xephyre57/projet-1A-controleur-moteur/docs/mb1419_bom/MB1419-G431CBU6-B01_BOM.xlsx

 |  |  | Bill of materials
 |  |  | Board reference: | MB1419
 |  |  | Variant: | G431CBU6
 |  |  | PCB revision: | B
 |  |  | Assembly revision: | 01
 |  |  | Date: | 20/03/2019
Designator | Description | Package | Manufacturer | Manufacturer_Part_Number | Fitted | Quantity
C1 C2 C3 C4 C5 C9 C13 C17 C18 C20 C21 C22 C23 C24 C70 | CAP CER 0.1UF 16V X7R 0402 | 0402 (1005 Metric) | Wurth Electronics Inc. | 885012205037 |  | 15
C6 | CAP CER 10UF 16V X5R 0805 | 0805 (2012 Metric) | Wurth Electronics Inc. | 885012107014 |  | 1
C7 | CAP CER 4.7UF 16V X5R 0805 | 0805 (2012 Metric) | Wurth Electronics Inc. | 885012107013 |  | 1
C8 | CAP CER 100PF 10V C0G/NP0 0402 | 0402 (1005 Metric) | Wurth Electronics Inc. | 885012005013 |  | 1
C10 C11 C67 C68 C69 | CAP CER 10PF 10V C0G/NP0 0402 | 0402 (1005 Metric) | Wurth Electronics Inc. | 885012005007 |  | 5
C12 | CAP CER 0402-NOT MOUNTED | 0402 (1005 Metric) |  |  | Not Fitted | 1
C14 C16 | CAP CER 1UF 16V X5R 0603 | 0603 (1608 Metric) | Yageo | CC0603KRX5R7BB105 |  | 2
C15 | CAP CER 0.1UF 16V X7R 0603 | 0603 (1608 Metric) | Wurth Electronics Inc. | 885012206046 |  | 1
C19 | CAP CER 4.7UF 10V X5R 0603 | 0603 (1608 Metric) | Wurth Electronics Inc. | 885012106012 |  | 1
C25 C56 C63 | CAP CER 1UF 25V X5R 0402 | 0402 (1005 Metric) | Murata Electronics North America | GRM155R61E105KA12D |  | 3
C26 | CAP CER 10000PF 16V X7R 0402 | 0402 (1005 Metric) | Wurth Electronics Inc. | 885012205031 |  | 1
C27 C28 C29 C30 C31 C32 C33 C34 C35 C36 C37 C38 C39 C40 | CAP CER 15UF 35V X5R 0805 | 0805 (2012 Metric) | TDK Corporation | C2012X5R1V156M125AC |  | 14
C41 | CAP CER 0.22UF 50V X7R 0603 | 0603 (1608 Metric) | TDK Corporation | CGA3E3X7R1H224K080AD |  | 1
C42 | CAP CER 3900PF 16V X7R 0402 | 0402 (1005 Metric) | KEMET | C0402C392K4RAC7867 |  | 1
C43 C52 C58 | CAP CER 1UF 25V X7R 0603 | 0603 (1608 Metric) | Wurth Electronics Inc. | 885012206076 |  | 3
C44 | CAP CER 10UF 50V X7R 1206 | 1206 (3216 Metric) | Samsung Electro-Mechanics America, Inc. | CL31B106KBHNNNE |  | 1
C45 | CAP CER 22UF 25V X5R 1206 | 1206 (3216 Metric) | Murata Electronics North America | GRT31CR61E226ME01L |  | 1
C46 | CAP CER 27PF 25V C0G/NP0 0402 | 0402 (1005 Metric) | Murata Electronics North America | GRM1555C1E270JA01D |  | 1
C47 C48 C53 C54 C60 C61 | CAP CER 100PF 25V X7R 0402 | 0402 (1005 Metric) | Wurth Electronics Inc. | 885012205038 |  | 6
C49 C55 C62 | CAP CER 0.47UF 25V X7R 0603 | 0603 (1608 Metric) | Wurth Electronics Inc. | 885012206075 |  | 3
C50 | CAP CER 4700PF 16V X7R 0402 | 0402 (1005 Metric) | Wurth Electronics Inc. | 885012205029 |  | 1
C51 C59 C65 | CAP CER 10000PF 100V X7R 0603 | 0603 (1608 Metric) | TDK Corporation | C1608X7R2A103M080AA |  | 3
C57 C64 | CAP CER 2.2UF 10V X5R 0402 | 0402 (1005 Metric) | Wurth Electronics Inc. | 885012105013 |  | 2
C66 | CAP CER 10000PF 10V X7R 0402 | 0402 (1005 Metric) | Wurth Electronics Inc. | 885012205012 |  | 1
D1 | DIODE SCHOTTKY 20V 1A STMITEFLAT | DO-222AA | STMicroelectronics | STPS1L20MF |  | 1
D2 | LED GREEN/RED CLEAR 4PLCC SMD | 4-PLCC | Wurth Electronics Inc. | 150141RV73100 |  | 1
D3 D5 | LED GREEN 0402 SMD | 0402 (1005 Metric) | Panasonic Electronic Components | LNJ347W83RA |  | 2
D4 | DIO, Rectangle with Flat Top, 1.00mm x 0.50mm, VLMS1500-GS08, 20mA, --, --, 0402 (1005 Metric) | 0402 (1005 Metric) | Vishay Semiconductor Opto Division | VLMS1500-GS08 |  | 1
D6 D8 D9 | DIODE SCHOTTKY 60V 500MA SOD123 | SOD-123 | STMicroelectronics | STPS0560Z |  | 3
D7 | DIODE SCHOTTKY 40V 1A STMITE | DO-216AA | STMicroelectronics | STPS1L40M |  | 1
D10 D11 D12 D13 D14 D15 D16 D17 D18 D19 | DIODE SCHOTTKY 30V 300MA SOD523 | SC-79, SOD-523 | STMicroelectronics | BAT30KFILM |  | 10
D20 | 400 W TVS in STmite Flat | DO216-AA-FLAT | STMicroelectronics | SMM4F26A-TR |  | 1
F1 | FUSE BOARD MNT 250MA 32VDC 0402 | 0.039" L x 0.020" W x 0.013" H (0.99mm x 0.51mm x 0.33mm) | Littelfuse Inc. | 0435.250KRS |  | 1
J1 | SOLDER PADS |  |  |  | Not Fitted | 1
J2 | SOLDER PADS |  |  |  | Not Fitted | 1
J3 | SOLDER PADS |  |  |  | Not Fitted | 1
J4 | SOLDER PADS |  |  |  | Not Fitted | 1
J5 | SOLDER PADS |  |  |  | Not Fitted | 1
J6 | SOLDER PADS |  |  |  | Not Fitted | 1
J7 | SOLDER PADS |  |  |  | Not Fitted | 1
J8 | SOLDER PADS |  |  |  | Not Fitted | 1
JP1 JP2 JP3 | 2 PIN SHORTED TO CONNECT DIFFERENT NETS |  |  |  | Not Fitted | 3
L1 | FERRITE BEAD 600 OHM 0402 1LN | 0402 (1005 Metric) | Murata Electronics North America | BLM15BX601SN1D |  | 1
L2 | Fixed Inductors LPS4018 Low Profile 33uH 0.8A 20% SMD | 3.9x3.9x1.7 | Coilcraft | LPS4018-333MRB |  | 1
Q1 | TRANS NPN 60V 1A SOT-23 | TO-236-3, SC-59, SOT-23-3 | STMicroelectronics | 2STR1160 |  | 1
Q2 Q3 Q4 Q5 Q6 Q7 | N-channel 60 V, 1.9 mO typ., 120 A STripFET™ F7 | PowerFLAT 5x6 | STMicroelectronics | STL180N6F7 |  | 6
R1 | RES SMD 120 OHM 1% 1/16W 0402 | 0402 (1005 Metric) | Yageo | RC0402FR-07120RL |  | 1
R2 | TRIMMER 10K OHM 0.5W PC PIN | Square - 0.375" x 0.375" Face x 0.190" H (9.53mm x 9.53mm x 4.83mm) | Bourns Inc. | 3386P-1-103TLF |  | 1
R3 R10 R12 R16 R35 R39 R41 R45 R46 R48 R52 R53 R71 R72 R73 | RES SMD 10K OHM 1% 1/16W 0402 | 0402 (1005 Metric) | Yageo | RC0402FR-0710KL |  | 15
R4 R8 R9 R18 R20 | RES SMD 100 OHM 1% 1/16W 0402 | 0402 (1005 Metric) | TE Connectivity Passive Product | CRG0402F100R |  | 5
R5 R67 R69 R70 | RES SMD 1.5K OHM 1% 1/16W 0402 | 0402 (1005 Metric) | Yageo | RC0402FR-071K5L |  | 4
R6 | RES SMD 36K OHM 1% 1/16W 0402 | 0402 (1005 Metric) | Yageo | RC0402FR-0736KL |  | 1
R7 R13 R15 | RES SMD 100K OHM 1% 1/16W 0402 | 0402 (1005 Metric) | TE Connectivity Passive Product | CRG0402F100K |  | 3
R11 R26 | RES SMD 0 OHM JUMPER 1/16W 0402 | 0402 (1005 Metric) | Vishay Dale | CRCW04020000Z0ED |  | 2
R14 | RES SMD 2.7K OHM 1% 1/16W 0402 | 0402 (1005 Metric) | Yageo | RC0402FR-072K7L |  | 1
R17 | RES SMD 0402 - NOT MOUNTED | 0402 (1005 Metric) |  |  | Not Fitted | 1
R19 R22 R30 R60 | RES SMD 4.7K OHM 1% 1/16W 0402 | 0402 (1005 Metric) | TE Connectivity Passive Product | CRG0402F4K7 |  | 4
R21 | RES SMD 1K OHM 1% 1/16W 0402 | 0402 (1005 Metric) | Yageo | RC0402FR-071KL |  | 1
R23 R24 | RES SMD 0 OHM JUMPER 1/10W 0603 | 0603 (1608 Metric) | Panasonic Electronic Components | ERJ-3GEY0R00V |  | 2
R27 | RES SMD 220 OHM 1% 1/16W 0402 | 0402 (1005 Metric) | Yageo | RC0402FR-07220RL |  | 1
R28 R29 | RES SMD 510 OHM 1% 1/16W 0402 | 0402 (1005 Metric) | Yageo | RC0402FR-07510RL |  | 2
R31 | RES SMD 62 OHM 1% 1/16W 0402 | 0402 (1005 Metric) | Yageo | RC0402FR-0762RL |  | 1
R32 | RES SMD 34.8K OHM 1% 1/16W 0402 | 0402 (1005 Metric) | Yageo | RC0402FR-0734K8L |  | 1
R33 | RES SMD 300 OHM 1% 1/16W 0402 | 0402 (1005 Metric) | Yageo | RC0402FR-07300RL |  | 1
R34 R38 R40 R43 R47 R50 | RES SMD 33 OHM 1% 1/10W 0603 | 0603 (1608 Metric) | Yageo | 9C06031A33R0FKHFT |  | 6
R36 | RES SMD 8.2K OHM 5% 1/16W 0402 | 0402 (1005 Metric) | Yageo | RC0402JR-078K2L |  | 1
R37 R44 R51 | RES SMD 1 OHM 5% 1/8W 0805 | 0805 (2012 Metric) | Panasonic Electronic Components | ERJ-6GEYJ1R0V |  | 3
R42 | RES SMD 52.3K OHM 1% 1/16W 0402 | 0402 (1005 Metric) | Samsung Electro-Mechanics | RC1005F5232CS |  | 1
R49 | RES SMD 30.9K OHM 1% 1/10W 0402 | 0402 (1005 Metric) | Panasonic Electronic Components | ERJ-2RKF3092X |  | 1
R54 R55 R56 | RES 0.003 OHM 1% 3W 2512 | 2512 (6432 Metric) | TE Connectivity Passive Product | TLR3A30DR003FTDG |  | 3
R57 R58 R59 | RES SMD 2.2K OHM 1% 1/16W 0402 | 0402 (1005 Metric) | Yageo | RC0402FR-072K2L |  | 3
R61 R62 R63 | RES SMD 10K OHM 1% 1/10W 0603 | 0603 (1608 Metric) | Yageo | RC0603FR-0710KL |  | 3
R68 | RES SMD 169K OHM 1% 1/16W 0402 | 0402 (1005 Metric) | Yageo | RC0402FR-07169KL |  | 1
R74 R75 R77 | RES SMD 1.8K OHM 1% 1/16W 0402 | 0402 (1005 Metric) | Yageo | RC0402FR-071K8L |  | 3
R76 | RES SMD 18K OHM 1% 1/16W 0402 | 0402 (1005 Metric) | Yageo | RC0402FR-0718KL |  | 1
RT1 | NTC THERMISTOR 10K OHM 1% 0402 | 0402 (1005 Metric) | TDK Corporation | NTCG103JF103FT1 |  | 1
R64 R65 R66 | RES SMD 22K OHM 1% 1/16W 0402 | 0402 (1005 Metric) | Panasonic Electronic Components | ERJ-2RKF2202X |  | 3
R80 R81 R82 | RES SMD 2.2K OHM 1% 1/16W 0402 | 0402 (1005 Metric) | Yageo | RC0402FR-072K2L |  | 3
SW1 | SWITCH TACTILE SPST-NO 0.05A 32V | 4.60mm x 2.80mm | C&K | KMR211GLFS |  | 1
TP1 TP2 TP3 | TEST POINT 1MM SMD PADSTASCK |  |  |  | Not Fitted | 3
U1 | IC ANLG SWITCH SGL SPDT 6QFN | 6-UFDFN | STMicroelectronics | AS11P2TLRQ |  | 1
U2 | IC TXRX CAN 3.3V SOT-23 | SOT-23-8 | Texas Instruments | TCAN330DCNT |  | 1
U3 | IC REG LINEAR 5V 800MA SOT223 | TO-261-4, TO-261AA | STMicroelectronics | LD1117S50TR |  | 1
U4 | CONN RCPT 5POS MICRO USB R/A |  | Molex, LLC | 0473460001 |  | 1
U5 | IC PWR SWITCH 1.2A HISIDE 8-DFN | 8-VDFN Exposed Pad | STMicroelectronics | ST890DTR |  | 1
U6 | IC MCU 32BIT 128KB FLASH 48LQFP | 48-LQFP | STMicroelectronics | STM32F103CBT6 |  | 1
U7 | IC REG LINEAR 3.3V 500MA 6DFN | 6-VDFN Exposed Pad | STMicroelectronics | LD39050PU33R |  | 1
U8 | IC MCU 32BIT | 48-UFQFPN | STMicroelectronics | STM32G431CBU6 |  | 1
U9 | IC REG BUCK ADJ 3A 10VDFPN | 10-VFDFN Exposed Pad | STMicroelectronics | L7986TR |  | 1
U10 U11 U13 | IC DRIVER HI/LO SIDE HV 8-SOIC | 8-SOIC (0.154", 3.90mm Width) | STMicroelectronics | L6387ED |  | 3
U12 U14 | IC REG LINEAR POS ADJ 1A 6DFN | 6-VDFN Exposed Pad | STMicroelectronics | LDFPVR |  | 2
Y1 | CRYSTAL 8.0000MHZ 8PF SMD | 0.126" L x 0.098" W (3.20mm x 2.50mm) | NDK America, Inc. | NX3225GD-8MHZ-STD-CRA-3 |  | 1
Y2 | CER RES 8.0000MHZ 33PF SMD | 0.126" L x 0.051" W (3.20mm x 1.30mm) | Murata Electronics North America | CSTCE8M00G15C99-R0 |  | 1
