xephyre57/projet-1A-controleur-moteur/(list of files, drawings)

Other design files:
docs/mb1419_bdp/MB1419_B01/CAN.SchDoc
docs/mb1419_bdp/MB1419_B01/DAUGHTERBOARD.SchDoc
docs/mb1419_bdp/MB1419_B01/MB1419.PrjPcb
docs/mb1419_bdp/MB1419_B01/MCU.SchDoc
docs/mb1419_bdp/MB1419_B01/POWER STAGE.SchDoc
docs/mb1419_bdp/MB1419_B01/Project_Overview.SchDoc
docs/mb1419_bdp/MB1419_B01/SENSING.SchDoc
docs/mb1419_bdp/MB1419_B04/CAN.SchDoc
docs/mb1419_bdp/MB1419_B04/DAUGHTERBOARD.SchDoc
docs/mb1419_bdp/MB1419_B04/MB1419.PrjPcb
docs/mb1419_bdp/MB1419_B04/MCU.SchDoc
docs/mb1419_bdp/MB1419_B04/POWER STAGE.SchDoc
docs/mb1419_bdp/MB1419_B04/Project_Overview.SchDoc
docs/mb1419_bdp/MB1419_B04/SENSING.SchDoc
docs/mb1419_bdp/MB1419_C01/CAN.SchDoc
docs/mb1419_bdp/MB1419_C01/DAUGHTERBOARD.SchDoc
docs/mb1419_bdp/MB1419_C01/MB1419.PrjPcb
docs/mb1419_bdp/MB1419_C01/MCU.SchDoc
docs/mb1419_bdp/MB1419_C01/POWER STAGE.SchDoc
docs/mb1419_bdp/MB1419_C01/Project_Overview.SchDoc
docs/mb1419_bdp/MB1419_C01/SENSING.SchDoc
