xephyre57/projet-1A-controleur-moteur/Control-Board/Kicad/BLDC-Control-Board.kicad_pcb

## KiCad design Control-Board/Kicad/BLDC-Control-Board.kicad_pcb (2026-05-30)

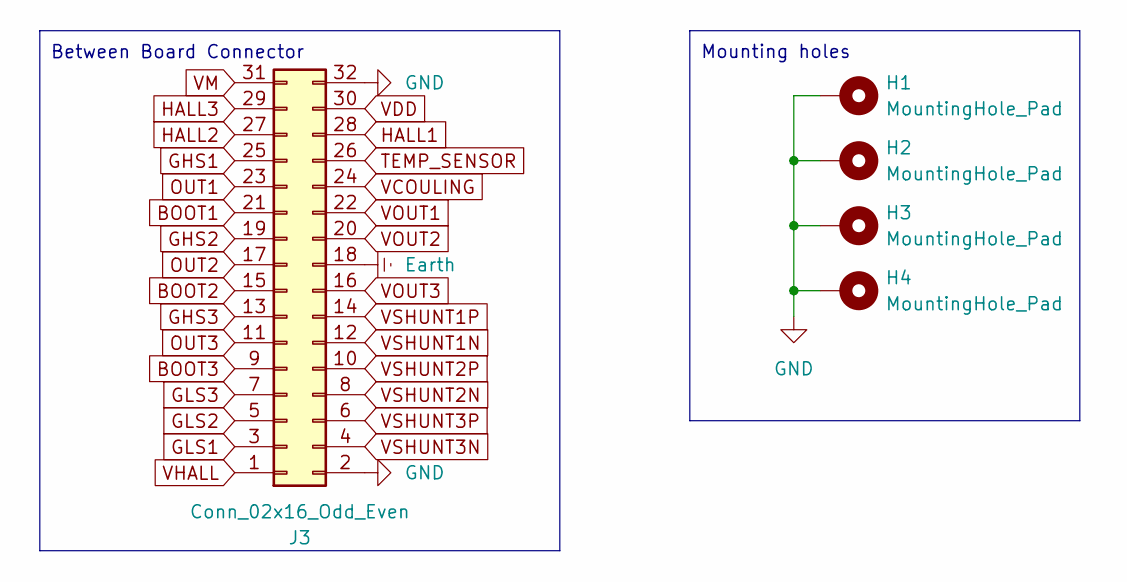
[picture p23: schematic connector.kicad_sch, BLDC Control Board]

Parts:
H1, H2, H3, H4: MountingHole_Pad; MountingHole_3.2mm_M3_DIN965_Pad
J3: Conn_02x16_Odd_Even; PinHeader_2x16_P2.54mm_Vertical

Connections:
BOOT1: J3.21; also elsewhere on the board
BOOT2: J3.15; also elsewhere on the board
BOOT3: J3.9; also elsewhere on the board
Earth: H1.1, H2.1, H3.1, H4.1, J3.2, J3.18, J3.32; also elsewhere on the board
GHS1: J3.25; also elsewhere on the board
GHS2: J3.19; also elsewhere on the board
GHS3: J3.13; also elsewhere on the board
GLS1: J3.3; also elsewhere on the board
GLS2: J3.5; also elsewhere on the board
GLS3: J3.7; also elsewhere on the board
HALL1: J3.28; also elsewhere on the board
HALL2: J3.27; also elsewhere on the board
HALL3: J3.29; also elsewhere on the board
OUT1: J3.23; also elsewhere on the board
OUT2: J3.17; also elsewhere on the board
OUT3: J3.11; also elsewhere on the board
TEMP_SENSOR: J3.26; also elsewhere on the board
VBAT: J3.30; also elsewhere on the board
VCOULING: J3.24; also elsewhere on the board
VHALL: J3.1; also elsewhere on the board
VM: J3.31; also elsewhere on the board
VOUT1: J3.22; also elsewhere on the board
VOUT2: J3.20; also elsewhere on the board
VOUT3: J3.16; also elsewhere on the board
VSHUNT1N: J3.12; also elsewhere on the board
VSHUNT1P: J3.14; also elsewhere on the board
VSHUNT2N: J3.8; also elsewhere on the board
VSHUNT2P: J3.10; also elsewhere on the board
VSHUNT3N: J3.4; also elsewhere on the board
VSHUNT3P: J3.6; also elsewhere on the board

Notes on the sheet:
Mounting holes
Between Board Connector

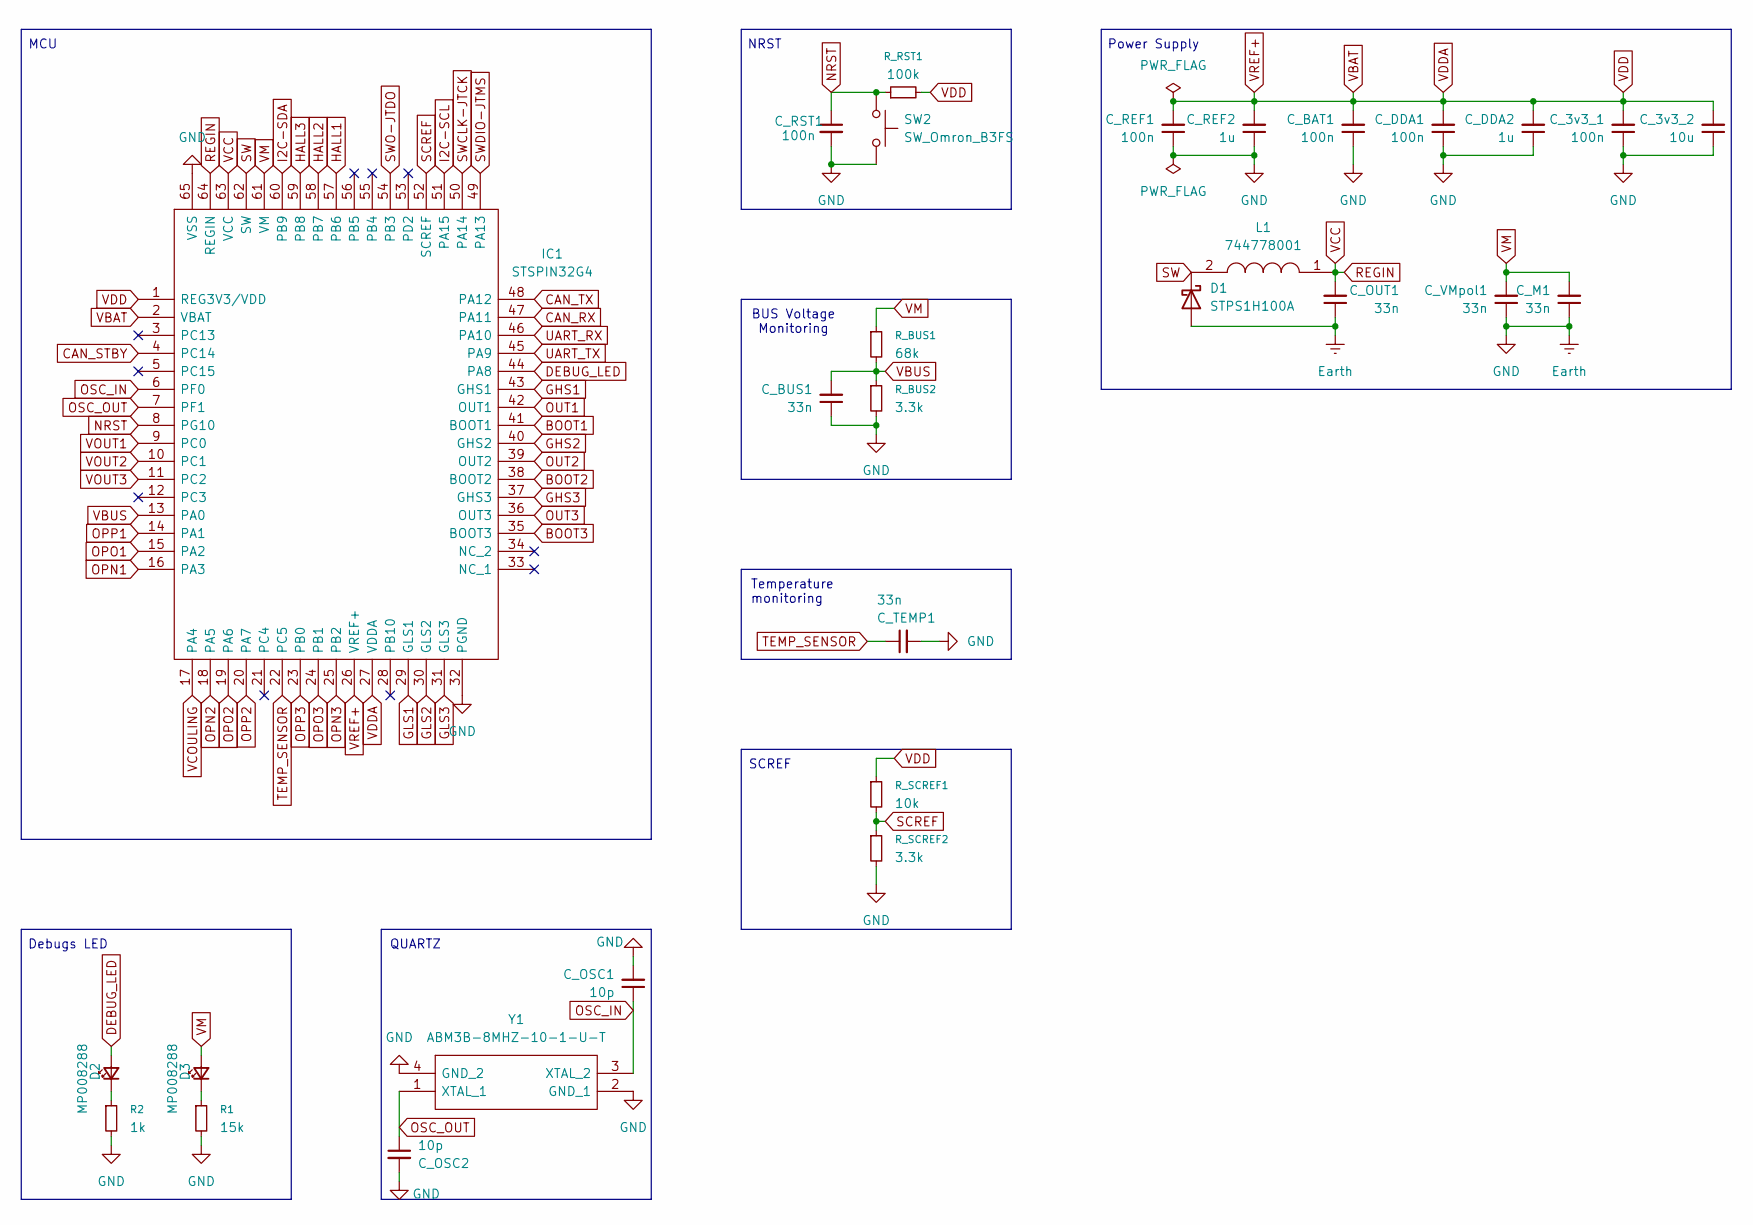
[picture p24: schematic MCU.kicad_sch, BLDC Control Board]

Parts:
C_3v3_1: 100n; C_0603_1608Metric_Pad1.08x0.95mm_HandSolder
C_3v3_2: 10u; C_0603_1608Metric_Pad1.08x0.95mm_HandSolder
C_BAT1: 100n; C_0603_1608Metric_Pad1.08x0.95mm_HandSolder
C_BUS1: 33n; C_0603_1608Metric_Pad1.08x0.95mm_HandSolder
C_DDA1: 100n; C_0603_1608Metric_Pad1.08x0.95mm_HandSolder
C_DDA2: 1u; C_0603_1608Metric_Pad1.08x0.95mm_HandSolder
C_M1: 33n; C_0603_1608Metric_Pad1.08x0.95mm_HandSolder
C_OSC1, C_OSC2: 10p; C_0603_1608Metric_Pad1.08x0.95mm_HandSolder
C_OUT1: 33n; C_0603_1608Metric_Pad1.08x0.95mm_HandSolder
C_REF1: 100n; C_0603_1608Metric_Pad1.08x0.95mm_HandSolder
C_REF2: 1u; C_0603_1608Metric_Pad1.08x0.95mm_HandSolder
C_RST1: 100n; C_0603_1608Metric_Pad1.08x0.95mm_HandSolder
C_TEMP1: 33n; C_0603_1608Metric_Pad1.08x0.95mm_HandSolder
C_VMpol1: 33n; C_0603_1608Metric_Pad1.08x0.95mm_HandSolder
D1: STPS1H100A; DIOM5126X265N
D2, D3: MP008288; LED_0603_1608Metric_Pad1.05x0.95mm_HandSolder
IC1: STSPIN32G4; QFN50P900X900X100-65N-D; Manufacturer_Part_Number STSPIN32G4; Mouser Part Number 511-STSPIN32G4
L1: 744778001; Manufacturer_Part_Number 744778001; Mouser Part Number 710-744778001
R1: 15k; R_0603_1608Metric_Pad0.98x0.95mm_HandSolder
R2: 1k; R_0603_1608Metric_Pad0.98x0.95mm_HandSolder
R_BUS1: 68k; R_0603_1608Metric_Pad0.98x0.95mm_HandSolder
R_BUS2: 3.3k; R_0603_1608Metric_Pad0.98x0.95mm_HandSolder
R_RST1: 100k; R_0603_1608Metric_Pad0.98x0.95mm_HandSolder
R_SCREF1: 10k; R_0603_1608Metric_Pad0.98x0.95mm_HandSolder
R_SCREF2: 3.3k; R_0603_1608Metric_Pad0.98x0.95mm_HandSolder
SW2: SW_Omron_B3FS; SW_SPST_Omron_B3FS-100xP
Y1: ABM3B-8MHZ-10-1-U-T; ABM3B; Manufacturer_Part_Number ABM3B-11.0592MHZ-10-1-U-T; Mouser Part Number 815-ABM3B-11.0592-T

Connections:
BOOT1: IC1.41 (BOOT1); also elsewhere on the board
BOOT2: IC1.38 (BOOT2); also elsewhere on the board
BOOT3: IC1.35 (BOOT3); also elsewhere on the board
CAN_RX: IC1.47 (PA11); also elsewhere on the board
CAN_STBY: IC1.4 (PC14); also elsewhere on the board
CAN_TX: IC1.48 (PA12); also elsewhere on the board
DEBUG_LED: D2.2 (A), IC1.44 (PA8)
Earth: C_3v3_1.1, C_3v3_2.1, C_BAT1.1, C_BUS1.1, C_DDA1.1, C_DDA2.1, C_M1.1, C_OSC1.2, C_OSC2.2, C_OUT1.1, C_REF1.1, C_REF2.1, C_RST1.2, C_TEMP1.2, C_VMpol1.1, D1.2 (A), IC1.32 (PGND), IC1.65 (VSS), R1.2, R2.2, R_BUS2.2, R_SCREF2.2, SW2.2, Y1.2 (GND_1), Y1.4 (GND_2); also elsewhere on the board
GHS1: IC1.43 (GHS1); also elsewhere on the board
GHS2: IC1.40 (GHS2); also elsewhere on the board
GHS3: IC1.37 (GHS3); also elsewhere on the board
GLS1: IC1.29 (GLS1); also elsewhere on the board
GLS2: IC1.30 (GLS2); also elsewhere on the board
GLS3: IC1.31 (GLS3); also elsewhere on the board
HALL1: IC1.57 (PB6); also elsewhere on the board
HALL2: IC1.58 (PB7); also elsewhere on the board
HALL3: IC1.59 (PB8); also elsewhere on the board
I2C-SCL: IC1.51 (PA15); also elsewhere on the board
I2C-SDA: IC1.60 (PB9); also elsewhere on the board
NRST: C_RST1.1, IC1.8 (PG10), R_RST1.1, SW2.1; also elsewhere on the board
unnamed: D2.1 (K), R2.1
unnamed: D3.1 (K), R1.1
OPN1: IC1.16 (PA3); also elsewhere on the board
OPN2: IC1.18 (PA5); also elsewhere on the board
OPN3: IC1.25 (PB2); also elsewhere on the board
OPO1: IC1.15 (PA2); also elsewhere on the board
OPO2: IC1.19 (PA6); also elsewhere on the board
OPO3: IC1.24 (PB1); also elsewhere on the board
OPP1: IC1.14 (PA1); also elsewhere on the board
OPP2: IC1.20 (PA7); also elsewhere on the board
OPP3: IC1.23 (PB0); also elsewhere on the board
OSC_IN: C_OSC1.1, IC1.6 (PF0), Y1.3 (XTAL_2)
OSC_OUT: C_OSC2.1, IC1.7 (PF1), Y1.1 (XTAL_1)
OUT1: IC1.42 (OUT1); also elsewhere on the board
OUT2: IC1.39 (OUT2); also elsewhere on the board
OUT3: IC1.36 (OUT3); also elsewhere on the board
REGIN: C_OUT1.2, IC1.63 (VCC), IC1.64 (REGIN), L1.1; also elsewhere on the board
SCREF: IC1.52 (SCREF), R_SCREF1.2, R_SCREF2.1
SW: D1.1 (K), IC1.62 (SW), L1.2
SWCLK-JTCK: IC1.50 (PA14); also elsewhere on the board
SWDIO-JTMS: IC1.49 (PA13); also elsewhere on the board
SWO-JTDO: IC1.54 (PB3); also elsewhere on the board
TEMP_SENSOR: C_TEMP1.1, IC1.22 (PC5); also elsewhere on the board
UART_RX: IC1.46 (PA10); also elsewhere on the board
UART_TX: IC1.45 (PA9); also elsewhere on the board
VBAT: C_3v3_1.2, C_3v3_2.2, C_BAT1.2, C_DDA1.2, C_DDA2.2, C_REF1.2, C_REF2.2, IC1.1 (REG3V3/VDD), IC1.2 (VBAT), IC1.26 (VREF+), IC1.27 (VDDA), R_RST1.2, R_SCREF1.1; also elsewhere on the board
VBUS: C_BUS1.2, IC1.13 (PA0), R_BUS1.2, R_BUS2.1
VCOULING: IC1.17 (PA4); also elsewhere on the board
VM: C_M1.2, C_VMpol1.2, D3.2 (A), IC1.61 (VM), R_BUS1.1; also elsewhere on the board
VOUT1: IC1.9 (PC0); also elsewhere on the board
VOUT2: IC1.10 (PC1); also elsewhere on the board
VOUT3: IC1.11 (PC2); also elsewhere on the board

Notes on the sheet:
QUARTZ
NRST
BUS Voltage Monitoring
Debugs LED
Power Supply
SCREF
MCU
Temperature monitoring

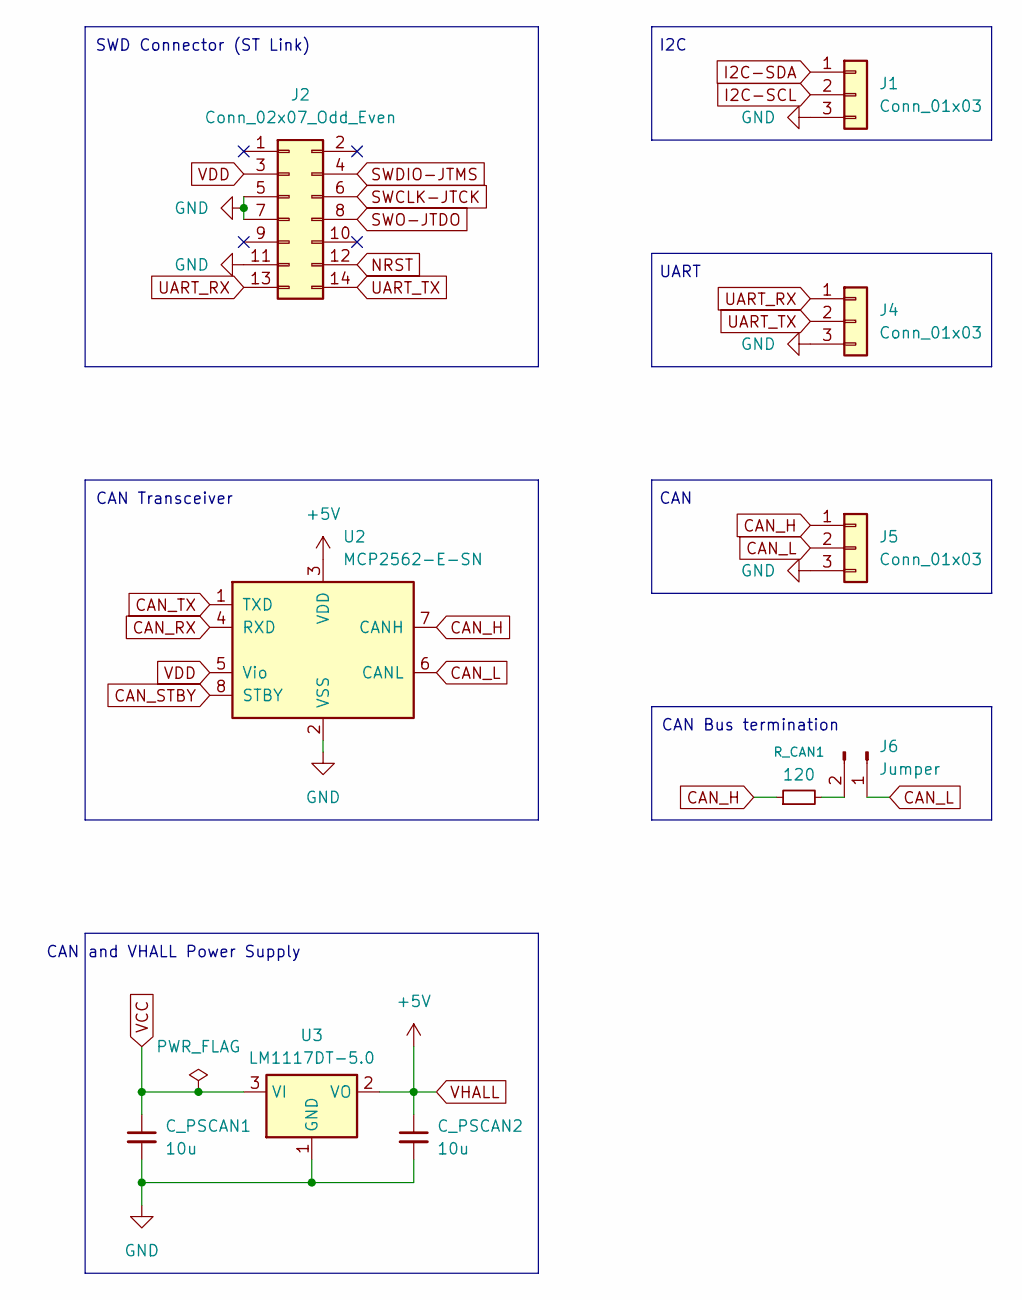
[picture p25: schematic communication.kicad_sch, BLDC Control Board]

Parts:
C_PSCAN1, C_PSCAN2: 10u; C_0603_1608Metric_Pad1.08x0.95mm_HandSolder
J1, J4, J5: Conn_01x03; JST_XH_B3B-XH-A_1x03_P2.50mm_Vertical
J2: Conn_02x07_Odd_Even; PinHeader_2x07_P2.54mm_Vertical_SMD
J6: Jumper; PinHeader_1x02_P2.54mm_Vertical
R_CAN1: 120; R_0603_1608Metric_Pad0.98x0.95mm_HandSolder
U2: MCP2562-E-SN; SOIC-8_3.9x4.9mm_P1.27mm
U3: LM1117DT-5.0; TO-252-3_TabPin2

Connections:
CAN_H: J5.1, R_CAN1.1, U2.7 (CANH)
CAN_L: J5.2, J6.1, U2.6 (CANL)
CAN_RX: U2.4 (RXD); also elsewhere on the board
CAN_STBY: U2.8 (STBY); also elsewhere on the board
CAN_TX: U2.1 (TXD); also elsewhere on the board
Earth: C_PSCAN1.2, C_PSCAN2.2, J1.3, J2.5, J2.7, J2.11, J4.3, J5.3, U2.2 (VSS), U3.1 (GND); also elsewhere on the board
I2C-SCL: J1.2; also elsewhere on the board
I2C-SDA: J1.1; also elsewhere on the board
NRST: J2.12; also elsewhere on the board
unnamed: J6.2, R_CAN1.2
REGIN: C_PSCAN1.1, U3.3 (VI); also elsewhere on the board
SWCLK-JTCK: J2.6; also elsewhere on the board
SWDIO-JTMS: J2.4; also elsewhere on the board
SWO-JTDO: J2.8; also elsewhere on the board
UART_RX: J2.13, J4.1; also elsewhere on the board
UART_TX: J2.14, J4.2; also elsewhere on the board
VBAT: J2.3, U2.5 (Vio); also elsewhere on the board
VHALL: C_PSCAN2.1, U2.3 (VDD), U3.2 (VO); also elsewhere on the board

Notes on the sheet:
CAN Transceiver
CAN
CAN Bus termination
I2C
UART
SWD Connector (ST Link)
CAN and VHALL Power Supply

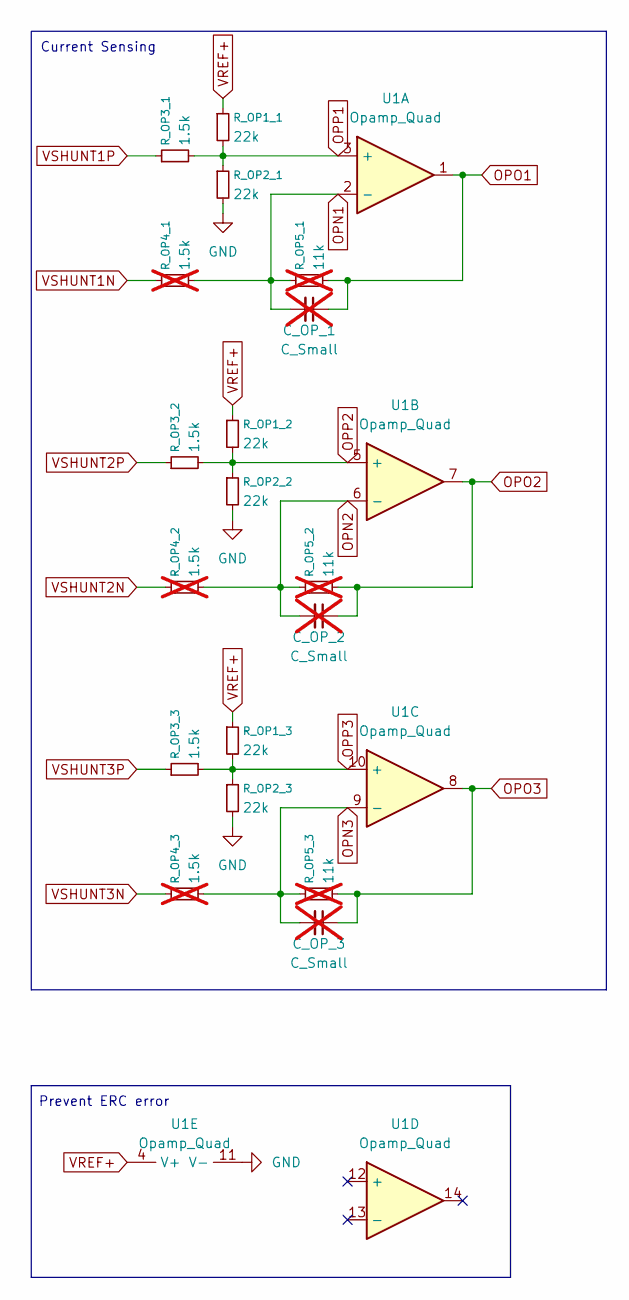
[picture p26: schematic analog-sensing.kicad_sch, BLDC Control Board]

Parts:
C_OP_1, C_OP_2, C_OP_3: C_Small; C_0603_1608Metric_Pad1.08x0.95mm_HandSolder; not fitted
R_OP1_1, R_OP1_2, R_OP1_3, R_OP2_1, R_OP2_2, R_OP2_3: 22k; R_0603_1608Metric_Pad0.98x0.95mm_HandSolder
R_OP3_1, R_OP3_2, R_OP3_3: 1.5k; R_0603_1608Metric_Pad0.98x0.95mm_HandSolder
R_OP4_1, R_OP4_2, R_OP4_3: 1.5k; R_0603_1608Metric_Pad0.98x0.95mm_HandSolder; not fitted
R_OP5_1, R_OP5_2, R_OP5_3: 11k; R_0603_1608Metric_Pad0.98x0.95mm_HandSolder; not fitted
U1: Opamp_Quad

Connections:
Earth: R_OP2_1.2, R_OP2_2.2, R_OP2_3.2, U1.11 (V-); also elsewhere on the board
OPN1: C_OP_1.2, R_OP4_1.2, R_OP5_1.1, U1.2 (-); also elsewhere on the board
OPN2: C_OP_2.2, R_OP4_2.2, R_OP5_2.1, U1.6 (-); also elsewhere on the board
OPN3: C_OP_3.2, R_OP4_3.2, R_OP5_3.1, U1.9 (-); also elsewhere on the board
OPO1: C_OP_1.1, R_OP5_1.2, U1.1; also elsewhere on the board
OPO2: C_OP_2.1, R_OP5_2.2, U1.7; also elsewhere on the board
OPO3: C_OP_3.1, R_OP5_3.2, U1.8; also elsewhere on the board
OPP1: R_OP1_1.2, R_OP2_1.1, R_OP3_1.2, U1.3 (+); also elsewhere on the board
OPP2: R_OP1_2.2, R_OP2_2.1, R_OP3_2.2, U1.5 (+); also elsewhere on the board
OPP3: R_OP1_3.2, R_OP2_3.1, R_OP3_3.2, U1.10 (+); also elsewhere on the board
VBAT: R_OP1_1.1, R_OP1_2.1, R_OP1_3.1, U1.4 (V+); also elsewhere on the board
VSHUNT1N: R_OP4_1.1; also elsewhere on the board
VSHUNT1P: R_OP3_1.1; also elsewhere on the board
VSHUNT2N: R_OP4_2.1; also elsewhere on the board
VSHUNT2P: R_OP3_2.1; also elsewhere on the board
VSHUNT3N: R_OP4_3.1; also elsewhere on the board
VSHUNT3P: R_OP3_3.1; also elsewhere on the board

Notes on the sheet:
Current Sensing
Prevent ERC error

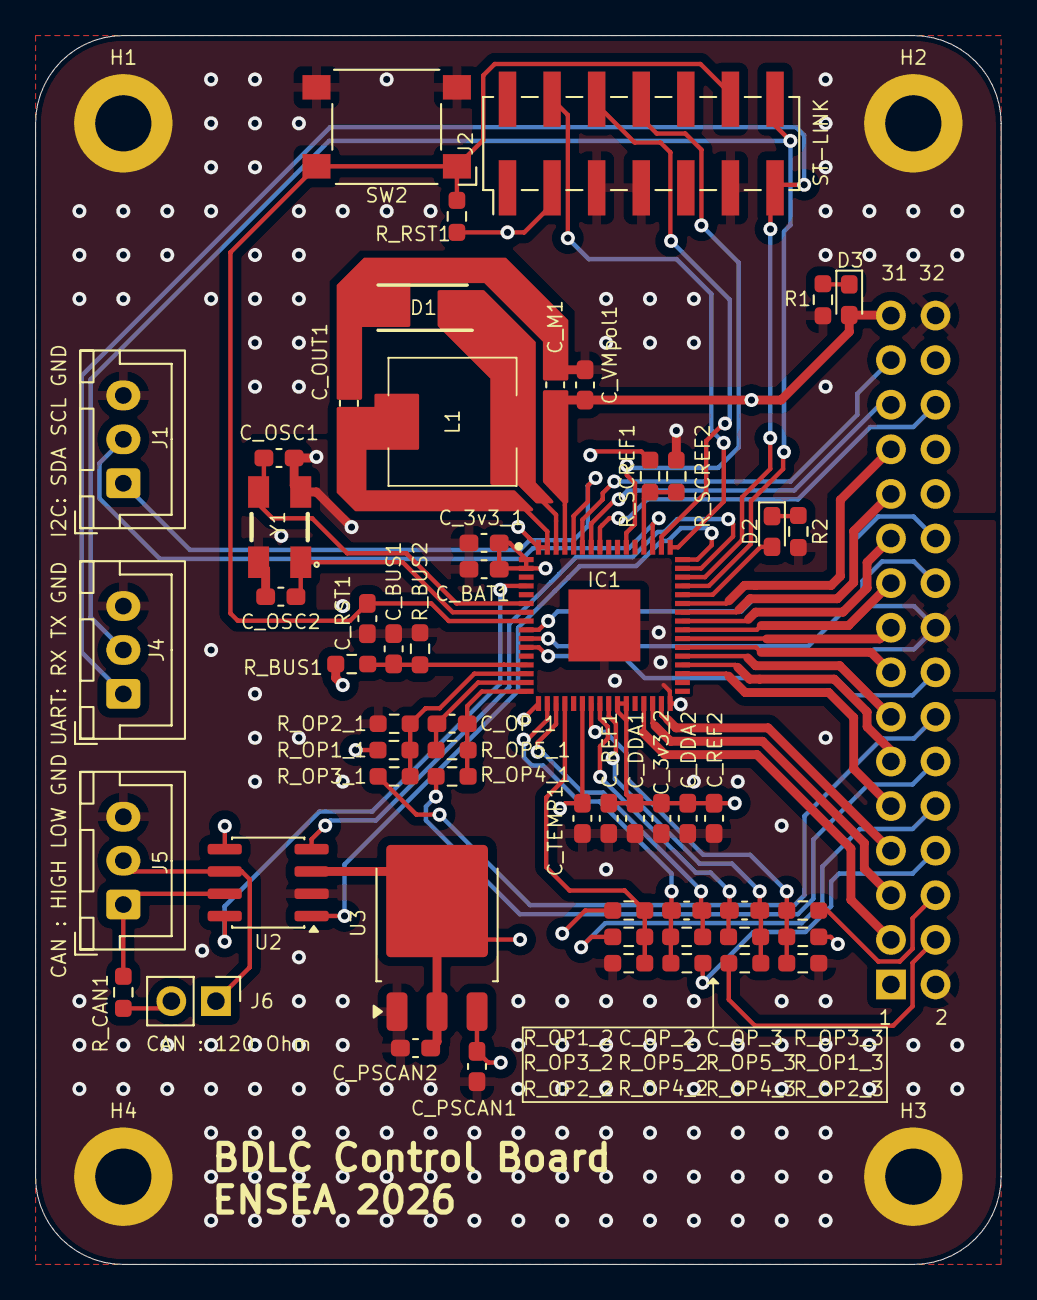
[picture p27: board BLDC-Control-Board.kicad_pcb from above]

Board: 4 copper layers, 55.0 x 70.0 mm, 62 parts (1 on the bottom side), 62 nets.
