xephyre57/projet-1A-controleur-moteur/(commit log)

2026-02-02 Ajout des premiers fichiers de documentation
    [CAN.SchDoc, DAUGHTERBOARD.SchDoc, MB1419-G431CBU6-B01_BOM.xlsx, MB1419-G431CBU6-B04_BOM.xlsx, MB1419-G431CBU6-C01_BOM.xlsx, MB1419.PrjPcb, MCU.SchDoc, POWER STAGE.SchDoc]
2026-05-30 Add control board doc
    - Control Board Schematic file
    - Control Board PCB file
    - Control Board Documentation
    [BLDC-Control-Board-B_Cu.gbr, BLDC-Control-Board-B_Mask.gbr, BLDC-Control-Board-B_Paste.gbr, BLDC-Control-Board-B_Silkscreen.gbr, BLDC-Control-Board-Edge_Cuts.gbr, BLDC-Control-Board-F_Cu.gbr, BLDC-Control-Board-F_Mask.gbr, BLDC-Control-Board-F_Paste.gbr]
2026-05-30 ajout de la partie software et du dimensionnement des composants du Control Board
